promit7473/stm32_flight_controller/hardware/stm32_f450_carrier_rev_a/PLACEMENT_CHECK.md

# Placement checks

Plan-view bounding boxes in board millimetres. Sensor envelopes are approximate.

- U2 MPU6050: (27.39, 58.00) to (48.39, 74.00), inside outline.
- U3 HMC5883L: (32.58, 27.00) to (45.58, 42.00), inside outline.
- U4 MS5611: (81.85, 73.00) to (98.85, 88.00), inside outline.
- Blue Pill including sockets/SWD: (53.70, 28.50) to (76.30, 83.32), inside outline.
- U2 MPU6050 / U3 HMC5883L: 16.00 mm envelope separation.
- U2 MPU6050 / U4 MS5611: 33.46 mm envelope separation.
- U2 MPU6050 / Blue Pill including sockets/SWD: 5.31 mm envelope separation.
- U3 HMC5883L / U4 MS5611: 47.71 mm envelope separation.
- U3 HMC5883L / Blue Pill including sockets/SWD: 8.12 mm envelope separation.
- U4 MS5611 / Blue Pill including sockets/SWD: 5.55 mm envelope separation.
