promit7473/stm32_flight_controller/hardware/stm32_f450_carrier_rev_a/stm32_f450_carrier_rev_a.kicad_pcb

## KiCad design hardware/stm32_f450_carrier_rev_a/stm32_f450_carrier_rev_a.kicad_pcb (2026-10-12)

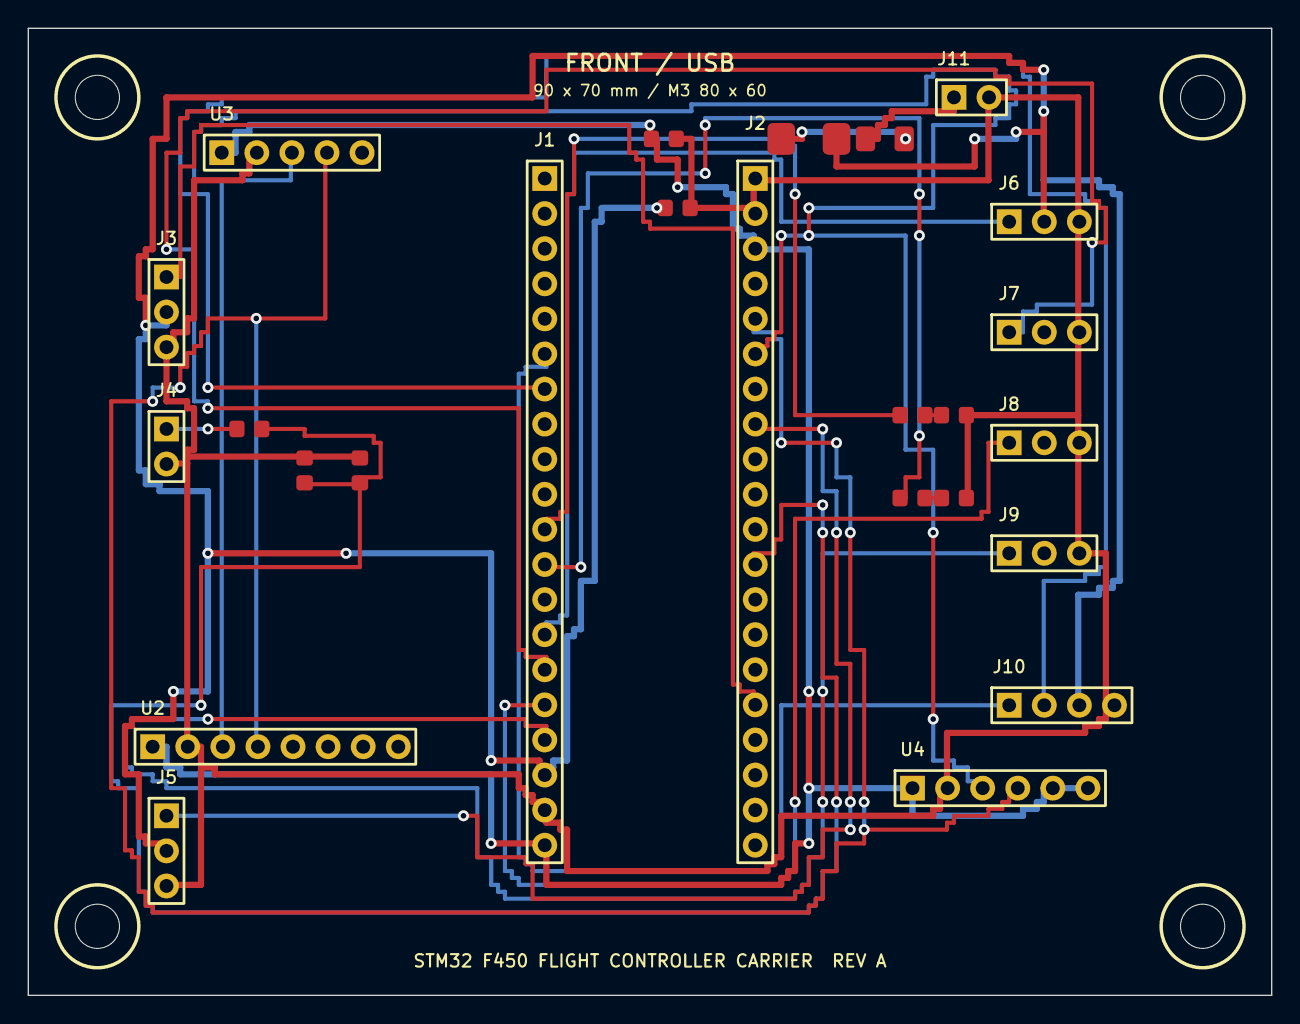
[picture p8: board stm32_f450_carrier_rev_a.kicad_pcb from above]

Board: 2 copper layers, 90.0 x 70.0 mm, 29 parts (0 on the bottom side), 21 nets.

Parts:
C1, C3: 100n; Carrier_0603
C2: 10u; Carrier_0603
D1: GREEN_LED; Carrier_0603
D2: RED_LED; Carrier_0603
D3: SS14_SMA; Carrier_0603
F1: PTC_500mA_1206; Carrier_0603
H1, H2, H3, H4: M3; MountingHole_M3
J1: BLUEPILL_LEFT; Carrier_Header
J2: BLUEPILL_RIGHT; Carrier_Header
J3: RC_PPM; Carrier_Header
J4: BATTERY_SENSE; Carrier_Header
J5: TELEMETRY; Carrier_Header
J6: ESC1_FRONT_RIGHT; Carrier_Header
J7: ESC2_REAR_RIGHT; Carrier_Header
J8: ESC3_REAR_LEFT; Carrier_Header
J9: ESC4_FRONT_LEFT; Carrier_Header
J10: GPS_UBLOX; Carrier_Header
J11: BEC_5V_INPUT; Carrier_Header
R1, R2: 330R; Carrier_0603
R3: 10k; Carrier_0603
R4: 1k; Carrier_0603
U2: GY521_MPU6050; Carrier_Header
U3: GY271_HMC5883L; Carrier_Header
U4: GY63_MS5611; Carrier_Header

Connections:
3V3: C3.1, J1.20, J2.3, U2.1, U3.1, U4.1, U4.5, U4.6
5V: C2.1, D3.2, J1.18, J3.2, J5.2, J6.2, J10.3
5V_IN: F1.1, J11.1
ESC1: J1.14, J6.1
ESC2: J1.15, J7.1
ESC3: J1.16, J8.1
ESC4: J1.17, J9.1
FUSED_5V: D3.1, F1.2
GND: C1.2, C2.2, C3.2, D1.2, D2.2, J1.19, J2.1, J2.2, J3.3, J4.2, J5.3, J6.3, J7.3, J8.3, J9.3, J10.4, J11.2, R4.2, U2.2, U3.2, U4.2
GPS_RX: J1.6, J10.1
GPS_TX: J1.7, J10.2
LED_GRN: J1.11, R1.1
LED_GRN_A: D1.1, R1.2
LED_RED: J1.12, R2.1
LED_RED_A: D2.1, R2.2
PPM: J2.16, J3.1
SCL: J2.6, U2.3, U3.3, U4.3
SDA: J2.5, U2.4, U3.4, U4.4
TLM_TX: J2.8, J5.1
VBAT: J4.1, R3.1
VBAT_SNS: C1.1, J2.12, R3.2, R4.1
