promit7473/stm32_flight_controller/firmware/flight_controller/telemetry.ino

///////////////////////////////////////////////////////////////////////////////////////////////////////////////////////////////////////
//This part sends the telemetry data to the ground station.
//The output for the serial monitor is PB0. Protocol is 1 arming_state bit, 8 data bits, no parity, 1 stop bit.
///////////////////////////////////////////////////////////////////////////////////////////////////////////////////////////////////////
void send_telemetry_data(void) {
  telemetry_loop_counter++;                                                                 //Increment the telemetry_loop_counter variable.
  if (telemetry_loop_counter == 1)telemetry_send_byte = 'J';                                //Send a J as arming_state signature.
  if (telemetry_loop_counter == 2)telemetry_send_byte = 'B';                                //Send a B as arming_state signature.
  if (telemetry_loop_counter == 3) {
    check_byte = 0;
    telemetry_send_byte = error;                              //Send the error as a byte.
  }
  if (telemetry_loop_counter == 4)telemetry_send_byte = flight_mode;                        //Send the flight mode as a byte.
  if (telemetry_loop_counter == 5)telemetry_send_byte = battery_voltage * 10;               //Send the battery voltage as a byte.
  if (telemetry_loop_counter == 6) {
    telemetry_buffer_byte = temperature;                                                    //Store the temperature as it can change during the next loop.
    telemetry_send_byte = telemetry_buffer_byte;                                            //Send the first 8 bytes of the temperature variable.
  }
  if (telemetry_loop_counter == 7)telemetry_send_byte = telemetry_buffer_byte >> 8;         //Send the last 8 bytes of the temperature variable.
  if (telemetry_loop_counter == 8)telemetry_send_byte = roll_angle + 100;                   //Send the roll angle as a byte. Adding 100 prevents negative numbers.
  if (telemetry_loop_counter == 9)telemetry_send_byte = pitch_angle + 100;                  //Send the pitch angle as a byte. Adding 100 prevents negative numbers.
  if (telemetry_loop_counter == 10)telemetry_send_byte = arming_state;                             //Send the error as a byte.
  if (telemetry_loop_counter == 11) {
    if (arming_state == 2) {                                                                       //Only send the altitude when the quadcopter is flying.
      telemetry_buffer_byte = 1000 + ((ground_pressure - actual_pressure) * 0.0842);        //Calculate the altitude and add 1000 to prevent negative numbers.
    }
    else {
      telemetry_buffer_byte = 1000;                                                         //Send and altitude of 0 meters if the quadcopter isn't flying.
    }
    telemetry_send_byte = telemetry_buffer_byte;                                            //Send the first 8 bytes of the altitude variable.
  }
  if (telemetry_loop_counter == 12)telemetry_send_byte = telemetry_buffer_byte >> 8;        //Send the last 8 bytes of the altitude variable.

  if (telemetry_loop_counter == 13) {
    telemetry_buffer_byte = 1500 + takeoff_throttle;                                        //Store the take-off throttle_base as it can change during the next loop.
    telemetry_send_byte = telemetry_buffer_byte;                                            //Send the first 8 bytes of the take-off throttle_base variable.
  }
  if (telemetry_loop_counter == 14)telemetry_send_byte = telemetry_buffer_byte >> 8;        //Send the last 8 bytes of the take-off throttle_base variable.
  if (telemetry_loop_counter == 15) {
    telemetry_buffer_byte = yaw_angle;                                                      //Store the compass heading as it can change during the next loop.
    telemetry_send_byte = telemetry_buffer_byte;                                            //Send the first 8 bytes of the compass heading variable.
  }
  if (telemetry_loop_counter == 16)telemetry_send_byte = telemetry_buffer_byte >> 8;        //Send the last 8 bytes of the compass heading variable.
  if (telemetry_loop_counter == 17)telemetry_send_byte = heading_lock;                      //Send the heading_lock variable as a byte.
  if (telemetry_loop_counter == 18)telemetry_send_byte = number_used_sats;                  //Send the number_used_sats variable as a byte.
  if (telemetry_loop_counter == 19)telemetry_send_byte = fix_type;                          //Send the fix_type variable as a byte.
  if (telemetry_loop_counter == 20) {
    telemetry_buffer_byte = l_lat_gps;                                                      //Store the latitude position as it can change during the next loop.
    telemetry_send_byte = telemetry_buffer_byte;                                            //Send the first 8 bytes of the latitude position variable.
  }
  if (telemetry_loop_counter == 21)telemetry_send_byte = telemetry_buffer_byte >> 8;        //Send the next 8 bytes of the latitude position variable.
  if (telemetry_loop_counter == 22)telemetry_send_byte = telemetry_buffer_byte >> 16;       //Send the next 8 bytes of the latitude position variable.
  if (telemetry_loop_counter == 23)telemetry_send_byte = telemetry_buffer_byte >> 24;       //Send the next 8 bytes of the latitude position variable.
  if (telemetry_loop_counter == 24) {
    telemetry_buffer_byte = l_lon_gps;                                                      //Store the longitude position as it can change during the next loop.
    telemetry_send_byte = telemetry_buffer_byte;                                            //Send the first 8 bytes of the longitude position variable.
  }
  if (telemetry_loop_counter == 25)telemetry_send_byte = telemetry_buffer_byte >> 8;        //Send the next 8 bytes of the longitude position variable.
  if (telemetry_loop_counter == 26)telemetry_send_byte = telemetry_buffer_byte >> 16;       //Send the next 8 bytes of the longitude position variable.
  if (telemetry_loop_counter == 27)telemetry_send_byte = telemetry_buffer_byte >> 24;       //Send the next 8 bytes of the longitude position variable.

  if (telemetry_loop_counter == 28) {
    telemetry_buffer_byte = adjustable_setting_1 * 100;                                     //Store the adjustable setting 1 as it can change during the next loop.
    telemetry_send_byte = telemetry_buffer_byte;                                            //Send the first 8 bytes of the adjustable setting 1.
  }
  if (telemetry_loop_counter == 29)telemetry_send_byte = telemetry_buffer_byte >> 8;        //Send the next 8 bytes of the adjustable setting 1.
  if (telemetry_loop_counter == 30) {
    telemetry_buffer_byte = adjustable_setting_2 * 100;                                     //Store the adjustable setting 1 as it can change during the next loop.
    telemetry_send_byte = telemetry_buffer_byte;                                            //Send the first 8 bytes of the adjustable setting 2.
  }
  if (telemetry_loop_counter == 31)telemetry_send_byte = telemetry_buffer_byte >> 8;        //Send the next 8 bytes of the adjustable setting 2.
  if (telemetry_loop_counter == 32) {
    telemetry_buffer_byte = adjustable_setting_3 * 100;                                     //Store the adjustable setting 1 as it can change during the next loop.
    telemetry_send_byte = telemetry_buffer_byte;                                            //Send the first 8 bytes of the adjustable setting 3.
  }
  if (telemetry_loop_counter == 33)telemetry_send_byte = telemetry_buffer_byte >> 8;        //Send the next 8 bytes of the adjustable setting 3.


  if (telemetry_loop_counter == 34)telemetry_send_byte = check_byte;                        //Send the check-byte.


  //After 125 loops the telemetry_loop_counter variable is reset. This way the telemetry data is send every half second.
  if (telemetry_loop_counter == 125)telemetry_loop_counter = 0;                             //After 125 loops reset the telemetry_loop_counter variable

  //Send the telemetry_send_byte via the serial protocol via ouput PB0.
  //Send a arming_state bit first.
  if (telemetry_loop_counter <= 34) {
    check_byte ^= telemetry_send_byte;
    GPIOB_BASE->BSRR = 0b1 << 16;                                                             //Reset output PB0 to 0 to create a arming_state bit.
    delayMicroseconds(104);                                                                   //Delay 104us (1s/9600bps)
    for (telemetry_bit_counter = 0; telemetry_bit_counter < 8; telemetry_bit_counter ++) {    //Create a loop fore every bit in the
      if (telemetry_send_byte >> telemetry_bit_counter & 0b1) GPIOB_BASE->BSRR = 0b1 << 0;    //If the specific bit is set, set output PB0 to 1;
      else GPIOB_BASE->BSRR = 0b1 << 16;                                                      //If the specific bit is not set, reset output PB0 to 0;
      delayMicroseconds(104);                                                                 //Delay 104us (1s/9600bps)
    }
    //Send a stop bit
    GPIOB_BASE->BSRR = 0b1 << 0;                                                              //Set output PB0 to 1;
  }
}
