promit7473/stm32_flight_controller/firmware/flight_controller/compass.ino

void read_compass() {
  HWire.beginTransmission(COMPASS_I2C_ADDRESS);                     //Start communication with the compass.
  HWire.write(0x03);                                            //We want to arming_state reading at the hexadecimal location 0x03.
  HWire.endTransmission();                                      //End the transmission with the gyro.

  HWire.requestFrom(COMPASS_I2C_ADDRESS, 6);                        //Request 6 bytes from the compass.
  compass_y = HWire.read() << 8 | HWire.read();                 //Add the low and high byte to the compass_y variable.
  compass_y *= -1;                                              //Invert the direction of the axis.
  compass_z = HWire.read() << 8 | HWire.read();                 //Add the low and high byte to the compass_z variable.;
  compass_x = HWire.read() << 8 | HWire.read();                 //Add the low and high byte to the compass_x variable.;
  compass_x *= -1;                                              //Invert the direction of the axis.

  //Before the compass can give accurate measurements it needs to be calibrated. At startup the compass_offset and compass_scale
  //variables are calculated. The following part will adjust the raw compas values so they can be used for the calculation of the heading.
  if (compass_calibration_on == 0) {                            //When the compass is not beeing calibrated.
    compass_y += compass_offset_y;                              //Add the y-offset to the raw value.
    compass_y *= compass_scale_y;                               //Scale the y-value so it matches the other axis.
    compass_z += compass_offset_z;                              //Add the z-offset to the raw value.
    compass_z *= compass_scale_z;                               //Scale the z-value so it matches the other axis.
    compass_x += compass_offset_x;                              //Add the x-offset to the raw value.
  }

  //The compass values change when the roll and pitch angle of the quadcopter changes. That's the reason that the x and y values need to calculated for a virtual horizontal position.
  //The 0.0174533 value is phi/180 as the functions are in radians in stead of degrees.
  compass_x_horizontal = (float)compass_x * cos(pitch_angle * -0.0174533) + (float)compass_y * sin(roll_angle * 0.0174533) * sin(pitch_angle * -0.0174533) - (float)compass_z * cos(roll_angle * 0.0174533) * sin(pitch_angle * -0.0174533);
  compass_y_horizontal = (float)compass_y * cos(roll_angle * 0.0174533) + (float)compass_z * sin(roll_angle * 0.0174533);

  //Now that the horizontal values are known the heading can be calculated. With the following lines of code the heading is calculated in degrees.
  //Please note that the atan2 uses radians in stead of degrees. That is why the 180/3.14 is used.
  if (compass_y_horizontal < 0)actual_compass_heading = 180 + (180 + ((atan2(compass_y_horizontal, compass_x_horizontal)) * (180 / 3.14)));
  else actual_compass_heading = (atan2(compass_y_horizontal, compass_x_horizontal)) * (180 / 3.14);

  actual_compass_heading += declination;                                 //Add the declination to the magnetic compass heading to get the geographic north.
  if (actual_compass_heading < 0) actual_compass_heading += 360;         //If the compass heading becomes smaller then 0, 360 is added to keep it in the 0 till 360 degrees range.
  else if (actual_compass_heading >= 360) actual_compass_heading -= 360; //If the compass heading becomes larger then 360, 360 is subtracted to keep it in the 0 till 360 degrees range.
}

//At startup the registers of the compass need to be set. After that the calibration offset and scale values are calculated.
void setup_compass() {
  HWire.beginTransmission(COMPASS_I2C_ADDRESS);                     //Start communication with the compass.
  HWire.write(0x00);                                            //We want to write to the Configuration Register A (00 hex).
  HWire.write(0x78);                                            //Set the Configuration Regiser A bits as 01111000 to set sample rate (average of 8 at 75Hz).
  HWire.write(0x20);                                            //Set the Configuration Regiser B bits as 00100000 to set the gain at +/-1.3Ga.
  HWire.write(0x00);                                            //Set the Mode Regiser bits as 00000000 to set Continues-Measurement Mode.
  HWire.endTransmission();                                      //End the transmission with the compass.

//Read the calibration values from the EEPROM.
  for (error = 0; error < 6; error ++)compass_cal_values[error] = EEPROM.read(0x10 + error);
  error = 0;
//Calculate the alibration offset and scale values
  compass_scale_y = ((float)compass_cal_values[1] - compass_cal_values[0]) / (compass_cal_values[3] - compass_cal_values[2]);
  compass_scale_z = ((float)compass_cal_values[1] - compass_cal_values[0]) / (compass_cal_values[5] - compass_cal_values[4]);

  compass_offset_x = (compass_cal_values[1] - compass_cal_values[0]) / 2 - compass_cal_values[1];
  compass_offset_y = (((float)compass_cal_values[3] - compass_cal_values[2]) / 2 - compass_cal_values[3]) * compass_scale_y;
  compass_offset_z = (((float)compass_cal_values[5] - compass_cal_values[4]) / 2 - compass_cal_values[5]) * compass_scale_z;
}


//The following subrouting calculates the smallest difference between two heading values.
float course_deviation(float course_b, float course_c) {
  course_a = course_b - course_c;
  if (course_a < -180 || course_a > 180) {
    if (course_c > 180)base_course_mirrored = course_c - 180;
    else base_course_mirrored = course_c + 180;
    if (course_b > 180)actual_course_mirrored = course_b - 180;
    else actual_course_mirrored = course_b + 180;
    course_a = actual_course_mirrored - base_course_mirrored;
  }
  return course_a;
}
