promit7473/stm32_flight_controller/firmware/flight_controller/settings.ino

///////////////////////////////////////////////////////////////////////////////////////////////////////////////////////////////////////
//In this part the settings that can be set via the transmitter are handled.
///////////////////////////////////////////////////////////////////////////////////////////////////////////////////////////////////////
//Changing the settings is explained in this video:
//https://youtu.be/ys-YpOaA2ME
///////////////////////////////////////////////////////////////////////////////////////////////////////////////////////////////////////
void change_settings(void) {
  red_led(HIGH);
  green_led(LOW);
  adjustable_setting_1 = variable_1_to_adjust;
  adjustable_setting_2 = variable_2_to_adjust;
  adjustable_setting_3 = variable_3_to_adjust;

  for (error = 0; error < 150; error ++) {
    delay(20);
    send_telemetry_data();
  }
  error = 0;

  while (rc_aux >= 1900) {
    delayMicroseconds(3700);
    send_telemetry_data();
    if (rc_roll > 1550)adjustable_setting_1 += (float)(rc_roll - 1550) * 0.000001;
    if (rc_roll < 1450)adjustable_setting_1 -= (float)(1450 - rc_roll) * 0.000001;
    if (adjustable_setting_1 < 0)adjustable_setting_1 = 0;
    variable_1_to_adjust = adjustable_setting_1;
    
    if (rc_pitch > 1550)adjustable_setting_2 += (float)(rc_pitch - 1550) * 0.000001;
    if (rc_pitch < 1450)adjustable_setting_2 -= (float)(1450 - rc_pitch) * 0.000001;
    if (adjustable_setting_2 < 0)adjustable_setting_2 = 0;
    variable_2_to_adjust = adjustable_setting_2;

    if (rc_yaw > 1550)adjustable_setting_3 += (float)(rc_yaw - 1550) * 0.000001;
    if (rc_yaw < 1450)adjustable_setting_3 -= (float)(1450 - rc_yaw) * 0.000001;
    if (adjustable_setting_3 < 0)adjustable_setting_3 = 0;
    variable_3_to_adjust = adjustable_setting_3;
  }
  loop_timer = micros();                                                           //Set the timer for the next loop.
  red_led(LOW);
}
