promit7473/stm32_flight_controller/(commit log)

2026-08-14 Import YMFC-32 autonomous flight controller as received
    Unmodified upstream sources, schematics, and my own build photos and test
    flight footage. Committed before any refactoring so every subsequent change
    to flight-critical code is reviewable as a diff.
2026-08-14 Restructure layout and rename identifiers to describe what they hold
    Layout: firmware/{flight_controller,test_bench,telemetry_receiver}, docs/,
    media/. Sketches renamed to match their folders as the Arduino IDE requires,
    and modules named for their job (gyro -> imu, calculate_pid -> control_pid,
    start_stop_takeoff -> arming, LED_control -> indicators).
    Renamed 84 identifiers over 703 occurrences: channel_1..6 became rc_roll,
    rc_pitch, rc_throttle, rc_yaw, rc_flight_mode, rc_aux; esc_1..4 became
    motor_front_right and friends, since the numbering carried no clue which
    corner of the frame each drives; PID state became roll_integrator,
    roll_previous_error, roll_rate_filtered and so on. Fixed th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
    [arming.ino, barometer.ino, calibration.ino, check_barometer.ino, compass.ino, control_pid.ino, flight_controller.ino, gps.ino]
2026-08-14 Extract configuration, share one rate controller across all three axes
    config.h now holds every tunable, address, pin and timing constant, each with
    the reasoning next to it: why the gyro filter is at 14 Hz, why the
    complementary filter tau is 10 s, why the throttle ceiling exists. The
    constants that are *not* free to change say so, in particular the attitude
    integration constants that silently encode the 250 Hz loop rate.
    Roll, pitch and yaw were three copies of the same twelve lines of PID. They
    now share updateRatePid(), with gains and state per axis in a RatePid struct.
    The nine-line integrator reset appeared twice in arming.ino and is now
    resetAllRatePids(). Flash fell 43952 -> 43280 b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
    [arming.ino, barometer.ino, check_barometer.ino, compass.ino, config.h, control_pid.ino, flight_controller.ino, gps.ino]
2026-08-14 Split loop() into named phases
    loop() was 185 lines in one block, so the order of operations, which is
    load-bearing, could only be reconstructed by reading all of it. It is now nine
    calls in flight_loop.ino:
    handleDisarmedRequests selectFlightMode readSensors
    updateAttitudeEstimate computeStickCommands runControllers
    computeBaseThrottle mixAndDriveMotors sendTelemetryAndWait
    The code was moved by script, not retyped, so no statement changed. Phase
    boundaries were placed only at brace depth zero, verified before and after;
    the first attempt cut inside the armed/disarmed if-else and the compiler
    caught it.
    Free, and provably so: flash is 43280 bytes and RAM 4072 bytes, byte-i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
2026-08-14 Point the test bench's serial help at the project README
    The two remaining brokking.net support URLs in the test-bench output were the
    last references in the firmware. Attribution now lives in one place, the
    Credits section of the README, where it is more prominent than a printed URL.
2026-08-14 Replace the schematics with a wiring diagram generated from the firmware
    The two PDFs carried a brokking.net watermark across the drawing and a title
    block crediting the original author, so they could not stay in a repository
    presented as my own work. Attribution belongs in the README credits, not
    stamped across a page.
    docs/wiring_diagram.svg is drawn from scratch, and every connection in it is
    cross-checked against the source rather than traced: TIM4 compare registers
    give the ESC pins, TIM2 input capture gives the receiver pin, Serial1 gives
    the GPS pins, HWire(2,...) gives the I2C pins.
    The battery divider is confirmed arithmetically. The firmware divides the ADC
    count by 112.81; a 10k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
2026-08-14 Redraw the wiring as a proper schematic sheet
    The previous drawing was neither a schematic nor a block diagram. It had
    paragraphs of prose inside its boxes, wires that doglegged through each other,
    two notes drawn with the same weight as real hardware, and no power
    distribution or ground at all, which is the first thing anyone building this
    needs. The one piece of actual circuitry, the battery divider, was hidden
    inside a text box.
    docs/schematic.svg is drawn the way a schematic is drawn:
    - Net labels instead of routed wires. Nothing with fifteen nets routes long
    lines across a page; tagged stubs remove every crossing.
    - Real symbols where there is real circuitry: divider resistors, LED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
2026-08-14 Note when the aircraft was built and how long it was flown
    The repository presents a finished state without saying it took years to
    reach. Built in 2023, then flown, re-tuned and upgraded repeatedly across my
    undergraduate years.
2026-08-14 Use math fences so the matrices survive the markdown parser
    The motor mixing matrix rendered as a single flattened row. GitHub processes
    the body of a $$...$$ block before KaTeX sees it and collapses the \ row
    separator to one backslash, so every row ran together.
    Inside a triple-backtick math fence the content is passed through verbatim and
    the separators survive. All 27 display blocks are converted, not just the
    broken one, since the same trap applies to any future matrix or alignment.
    Inline math is unaffected and untouched.
    Checked afterwards: 27 fences all closed, no stray delimiters, braces balanced
    in every block, no macros outside GitHub's allowed set.
2026-08-14 Keep the card-clip tooling in the repository
    The tracker and renderer that produced the website clip lived outside the
    project, so re-cutting it would have meant rebuilding them. tools/make_card_clip.py
    is that pipeline as one script: track, pan, crop, write.
    Its docstring records why the detector is a scale pyramid rather than
    something simpler. Two earlier versions failed, a darkness map that locked
    onto the tree line and a single-scale blob detector that could not cope with
    the drone's apparent size changing from most of the frame at take-off to a
    speck at altitude. Both produced plausible numbers while sitting on a tree,
    which is why --check draws the detection onto sample frames; that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
2026-10-12 Add F450 carrier PCB prototype and level assembly previews
